onurefe/Flow/Flow2D/Analysis/PhaseRx.png

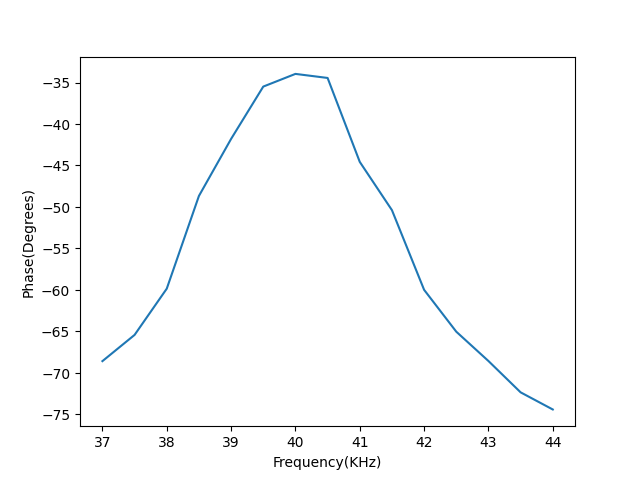
Flow2D/Analysis/PhaseRx.png
