onurefe/Flow/Flow1D/Hardware/BOM v1.0.ods

1u | https://ozdisan.com/passive-components/capacitors/smt-smd-and-mlcc-capacitors/CL10A105KO8NNNC | $0.01 | 6 | $0.05
10u | https://ozdisan.com/passive-components/capacitors/smt-smd-and-mlcc-capacitors/CL10A106MQ8NNNC | $0.02 | 1 | $0.02
100n | https://ozdisan.com/passive-components/capacitors/smt-smd-and-mlcc-capacitors/CL10B104KB8NNND | $0.00 | 6 | $0.03
1n %5 | https://ozdisan.com/passive-components/capacitors/smt-smd-and-mlcc-capacitors/CL21C102JBCNNNC | $0.01 | 1 | $0.01
1.5n %5 | https://ozdisan.com/passive-components/capacitors/smt-smd-and-mlcc-capacitors/CL21C152JBFNNNE | $0.05 | 1 | $0.05
2.2u | https://ozdisan.com/passive-components/capacitors/smt-smd-and-mlcc-capacitors/CL10A225KQ8NNNC | $0.01 | 1 | $0.01
22n | https://ozdisan.com/passive-components/capacitors/smt-smd-and-mlcc-capacitors/CC0603KRX7R9BB223 | $0.01 | 1 | $0.01
330n | https://ozdisan.com/passive-components/capacitors/smt-smd-and-mlcc-capacitors/CL10B334KO8NNNC | $0.02 | 1 | $0.02
47u 10v | https://ozdisan.com/passive-components/capacitors/tantalum-capacitors/TSK1A476TSSR | $0.16 | 1 | $0.16
2.2u 16v | https://ozdisan.com/passive-components/capacitors/smt-smd-and-mlcc-capacitors/CL10A225KO8NNNC | $0.02 | 2 | $0.04
Conn_01x04_Male | https://ozdisan.com/connectors-and-interconnects/headers/pin-headers/L-KLS1-207-1-04-S | $0.02 | 1 | $0.02
Conn_01x04_Male | https://ozdisan.com/connectors-and-interconnects/headers/pin-headers/L-KLS1-207C-2-0-1-12-S-5 | $0.10 | 1 | $0.10
Speaker_Ultrasound |  | $0.50 | 2 | $1.00
10k | https://ozdisan.com/passive-components/resistors/smt-smd-and-chip-resistors/HP03W5F1002T5E | $0.01 | 9 | $0.05
47k | https://ozdisan.com/passive-components/resistors/smt-smd-and-chip-resistors/RC0603JR-47KR | $0.00 | 1 | $0.00
1.4k %1 | https://ozdisan.com/passive-components/resistors/smt-smd-and-chip-resistors/0603SAF1401T5Ehttps://ozdisan.com/passive-components/resistors/smt-smd-and-chip-re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 | $0.00 | 1 | $0.00
2.21k %1 | https://ozdisan.com/passive-components/resistors/smt-smd-and-chip-resistors/0603SAF2211T5E | $0.00 | 1 | $0.00
470R | https://ozdisan.com/passive-components/resistors/smt-smd-and-chip-resistors/0603SAJ0471TDE | $0.00 | 1 | $0.00
22R | https://ozdisan.com/passive-components/resistors/smt-smd-and-chip-resistors/0603SAJ0220T5E | $0.00 | 2 | $0.00
4.7k | https://ozdisan.com/passive-components/resistors/smt-smd-and-chip-resistors/CQ03SAJ0472T5E | $0.00 | 1 | $0.00
NC7SB3157P6X | https://ozdisan.com/Product/Detail/487925/NC7SB3157P6X | $0.18 | 2 | $0.36
TLV9062 | https://ozdisan.com/Product/Detail/582269/TLV9062IDR | $0.64 | 1 | $0.64
STM32L031F4Px | https://ozdisan.com/Product/Detail/492349/STM32L031F4P6 | $2.85 | 1 | $2.85
LR9102G | https://ozdisan.com/Product/Detail/497420/LR9102G-33-AE5-R | $0.08 | 2 | $0.17
Cost | $5.59
