onurefe/Flow/Flow2D/v2/Hardware/JLCPCB-BOM.xlsx

Comment | Designator | Footprint | LCSC Part #
47u 10v | C2 | CP_EIA-3528-21_Kemet-B_Pad1.50x2.35mm_HandSolder | C123253
1u | C4, C5, C16, C17 | C_0603_1608Metric | C386079
100n | C1, C3, C6, C7, C10, C11, C12, C13 | C_0603_1608Metric | C187860
10u | C8, C9, C14, C15 | C_0603_1608Metric | C77040
Conn_02x05_Odd_Even | J1 |  | C124370
Speaker_Ultrasound | LS1, LS2, LS3, LS4 |  | C242175
1k | R6, R7, R13, R14, R15, R22, R23 | R_0603_1608Metric | C21190
18R | R4, R5, R12, R19, R20, R21 | R_0603_1608Metric | C403044
10k | R1, R2, R3, R8, R9, R10, R11, R16, R17, R18, R24, R25 | R_0603_1608Metric | C115324
SN74LVC2G17 | U1 | SOT-23-6 | C10429
LR9102G | U2 | SOT-23-5 | C211615
GS8724TR | U3 | SOIC-14_3.9x8.7mm_P1.27mm | C157710
STM32G030F6Px | U4 | TSSOP-20_4.4x6.5mm_P0.65mm | C529330
