onurefe/Flow/Flow2D/v1/Hardware/Flow.kicad_pcb

## KiCad design Flow2D/v1/Hardware/Flow.kicad_pcb (2022-01-21, an earlier design)

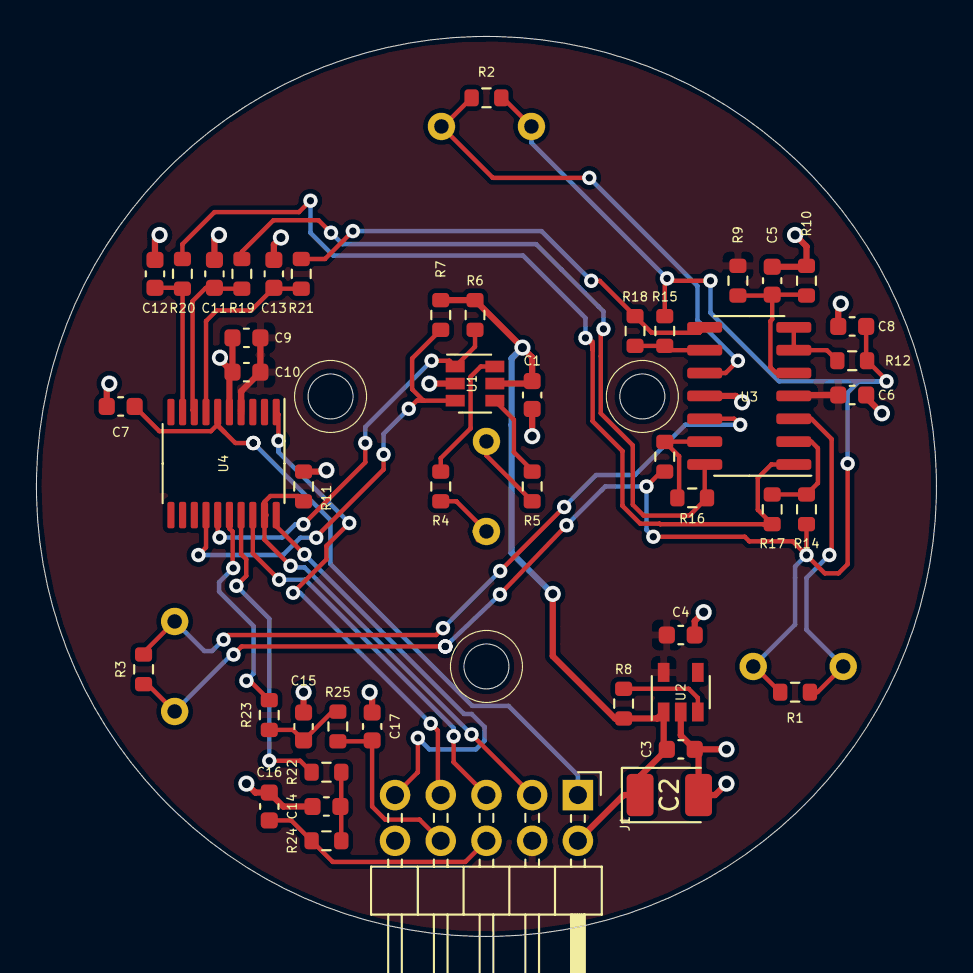
[picture p2: board Flow2D/v1/Hardware/Flow.kicad_pcb from above]

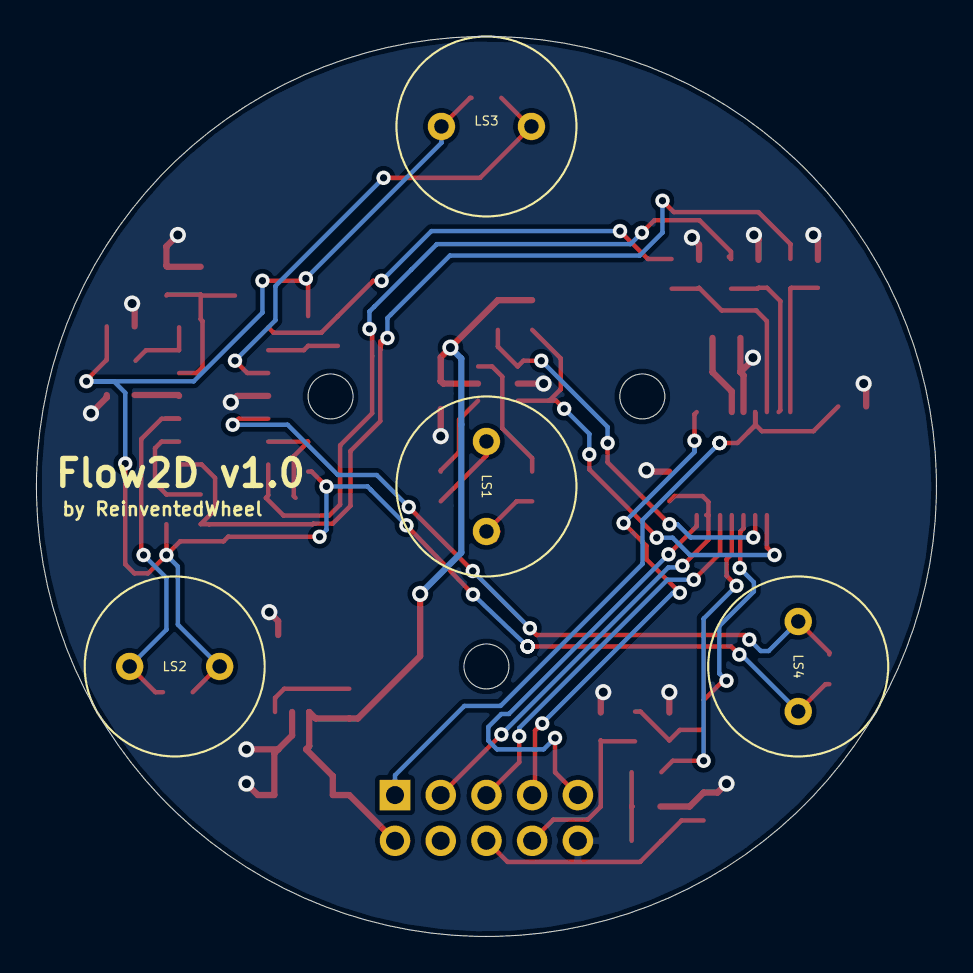
[picture p3: board Flow2D/v1/Hardware/Flow.kicad_pcb from below]

Board: 2 copper layers, 50.0 x 50.0 mm, 51 parts (4 on the bottom side), 36 nets.

Parts:
C1, C3, C6, C7, C10, C11, C12, C13: 100n; C_0603_1608Metric
C2: 47u 10v; CP_EIA-3528-21_Kemet-B_Pad1.50x2.35mm_HandSolder
C4, C5, C16, C17: 1u; C_0603_1608Metric
C8, C9, C14, C15: 10u; C_0603_1608Metric
J1: Conn_02x05_Odd_Even; PinHeader_2x05_P2.54mm_Horizontal
LS1, LS2, LS3, LS4: Speaker_Ultrasound; GU1007C-40TR
R1, R2, R3, R8, R9, R10, R11, R16, R17, R18, R24, R25: 12k; R_0603_1608Metric
R4, R5, R12, R19, R20, R21: 18R; R_0603_1608Metric
R6, R7, R13, R14, R15, R22, R23: 1k; R_0603_1608Metric
U1: SN74LVC2G17; SOT-23-6
U2: LR9102G; SOT-23-5
U3: TLV9064IDR; SOIC-14_3.9x8.7mm_P1.27mm
U4: STM32G030F6Px; TSSOP-20_4.4x6.5mm_P0.65mm

Connections:
+5V: C1.1, C2.1, C3.1, J1.2, R6.1, R7.1, R8.2, U1.5, U2.1
/CHA_A: C13.1, R21.1, U4.7
/CHA_B: C11.1, R19.1, U4.8
/CHA_C: C12.1, R20.1, U4.9
/NRST: C7.1, J1.1, U4.6
/OUT_X: C16.1, J1.6, R24.1
/OUT_Y: C17.1, J1.8, R25.1
/PULSE: R6.2, U1.1, U4.15
/PULSE_N: R7.2, U1.3, U4.14
/PWM_X: R22.2, U4.17
/PWM_Y: R23.2, U4.16
/SIGNAL_A: LS3.2, R2.1, U3.10
/SIGNAL_B: LS4.2, R3.1, U3.12
/SIGNAL_C: LS2.2, R1.1, U3.3
/SWCLK: J1.3, R11.1, U4.19
/SWDIO: J1.5, U4.18
/USART_RX: J1.7, U4.1
/USART_TX: J1.9, U4.20
/VGND: C8.1, LS2.1, LS3.1, LS4.1, R1.2, R2.2, R3.2, R12.1, R13.2, R14.2, R15.2
GND: C1.2, C2.2, C3.2, C4.1, C5.2, C6.1, C7.2, C8.2, C9.1, C10.2, C11.2, C12.2, C13.2, C14.1, C15.1, C16.2, C17.2, J1.10, R10.2, R11.2, U1.2, U2.2, U3.11, U4.5
unnamed: C5.1, R9.2, R10.1, U3.5
unnamed: C14.2, R22.1, R24.2
unnamed: C15.2, R23.1, R25.2
unnamed: LS1.1, R4.2
unnamed: LS1.2, R5.2
unnamed: R4.1, U1.6
unnamed: R5.1, U1.4
unnamed: R8.1, U2.3
unnamed: R12.2, U3.6, U3.7
unnamed: R13.1, R16.1, U3.13
unnamed: R14.1, R17.1, U3.2
unnamed: R15.1, R18.1, U3.9
unnamed: R16.2, R19.2, U3.14
unnamed: R17.2, R20.2, U3.1
unnamed: R18.2, R21.2, U3.8
VDD: C4.2, C6.2, C9.2, C10.1, J1.4, R9.1, U2.5, U3.4, U4.4
