onurefe/Flow/Flow1D/Hardware/Flow.kicad_pcb

## KiCad design Flow1D/Hardware/Flow.kicad_pcb (2021-05-09, an earlier design)

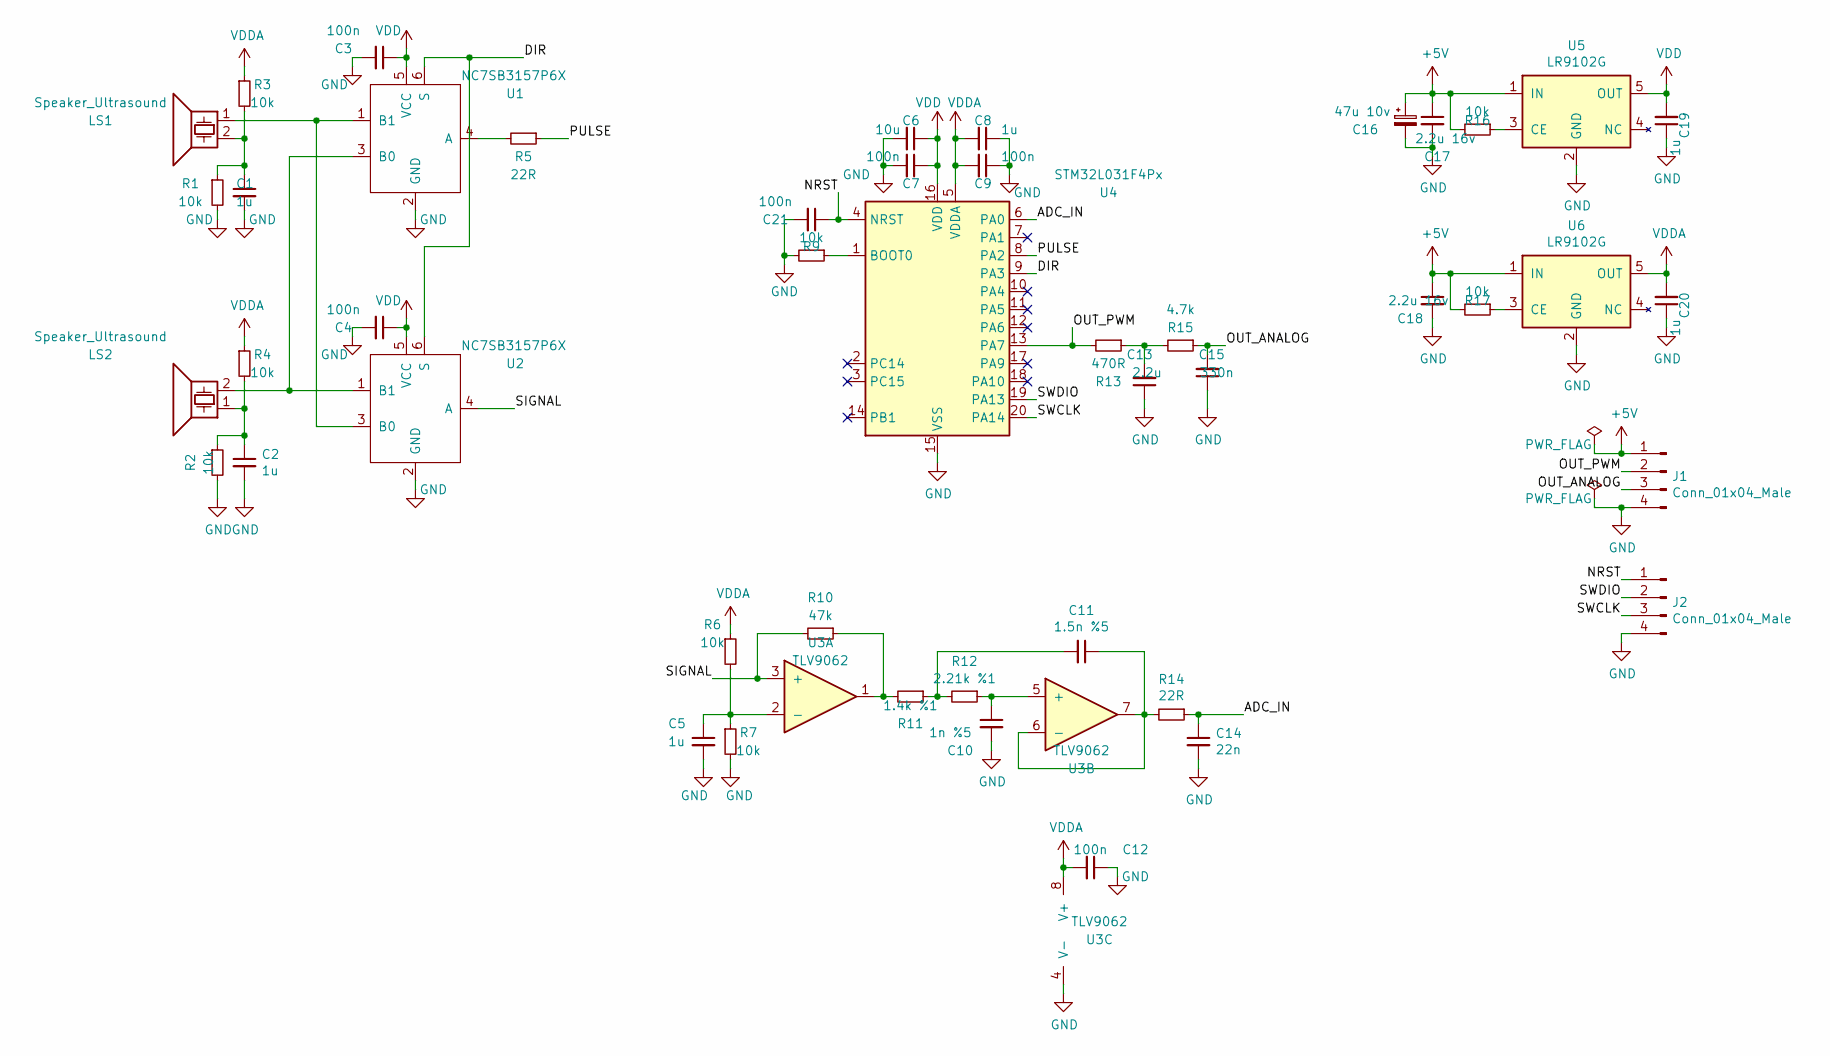
[picture p4: schematic Flow.sch]

Parts:
C1, C2, C5, C8, C19, C20: 1u; C_0603_1608Metric
C3, C4, C7, C9, C12, C21: 100n; C_0603_1608Metric
C6: 10u; C_0603_1608Metric
C10: 1n %5; C_0805_2012Metric
C11: 1.5n %5; C_0805_2012Metric
C13: 2.2u; C_0603_1608Metric
C14: 22n; C_0603_1608Metric
C15: 330n; C_0603_1608Metric
C16: 47u 10v; CP_EIA-3528-12_Kemet-T_Pad1.50x2.35mm_HandSolder
C17, C18: 2.2u 16v; C_0603_1608Metric
J1: Conn_01x04_Male; PinHeader_1x04_P2.54mm_Vertical
J2: Conn_01x04_Male; PinHeader_1x04_P1.27mm_Vertical
LS1, LS2: Speaker_Ultrasound; US_RXTX_10mm
R1, R2, R3, R4, R6, R7, R9, R16, R17: 10k; R_0603_1608Metric
R5, R14: 22R; R_0603_1608Metric
R10: 47k; R_0603_1608Metric
R11: 1.4k %1; R_0603_1608Metric
R12: 2.21k %1; R_0603_1608Metric
R13: 470R; R_0603_1608Metric
R15: 4.7k; R_0603_1608Metric
U1, U2: NC7SB3157P6X; SOT-363_SC-70-6_Handsoldering
U3: TLV9062; SOIC-8_3.9x4.9mm_P1.27mm
U4: STM32L031F4Px; TSSOP-20_4.4x6.5mm_P0.65mm
U5, U6: LR9102G; SOT-23-5_HandSoldering

Connections:
+5V: C16.1, C17.1, C18.1, J1.1, R16.2, R17.2, U5.1 (IN), U6.1 (IN)
/ADC_IN: C14.1, R14.1, U4.6 (PA0)
/DIR: U1.6 (S), U2.6 (S), U4.9 (PA3)
/NRST: C21.1, J2.1, U4.4 (NRST)
/OUT_ANALOG: C15.2, J1.3, R15.1
/OUT_PWM: J1.2, R13.2, U4.13 (PA7)
/PULSE: R5.1, U4.8 (PA2)
/SIGNAL: R10.2, U2.4 (A), U3.3 (+)
/SWCLK: J2.3, U4.20 (PA14)
/SWDIO: J2.2, U4.19 (PA13)
GND: C1.2, C2.2, C3.2, C4.2, C5.2, C6.2, C7.2, C8.1, C9.1, C10.2, C12.1, C13.1, C14.2, C15.1, C16.2, C17.2, C18.2, C19.1, C20.1, C21.2, J1.4, J2.4, R1.2, R2.2, R7.2, R9.2, U1.2 (GND), U2.2 (GND), U3.4 (V-), U4.15 (VSS), U5.2 (GND), U6.2 (GND)
unnamed: C1.1, LS1.2, R1.1, R3.2
unnamed: C2.1, LS2.1, R2.1, R4.2
unnamed: C5.1, R6.2, R7.1, U3.2 (-)
unnamed: C10.1, R12.1, U3.5 (+)
unnamed: C11.1, R14.2, U3.6 (-), U3.7
unnamed: C11.2, R11.1, R12.2
unnamed: C13.2, R13.1, R15.2
unnamed: LS1.1, U1.1 (B1), U2.3 (B0)
unnamed: LS2.2, U1.3 (B0), U2.1 (B1)
unnamed: R5.2, U1.4 (A)
unnamed: R9.1, U4.1 (BOOT0)
unnamed: R10.1, R11.2, U3.1
unnamed: R16.1, U5.3 (CE)
unnamed: R17.1, U6.3 (CE)
VDD: C3.1, C4.1, C6.1, C7.1, C19.2, U1.5 (VCC), U2.5 (VCC), U4.16 (VDD), U5.5 (OUT)
VDDA: C8.2, C9.2, C12.2, C20.2, R3.1, R4.1, R6.1, U3.8 (V+), U4.5 (VDDA), U6.5 (OUT)

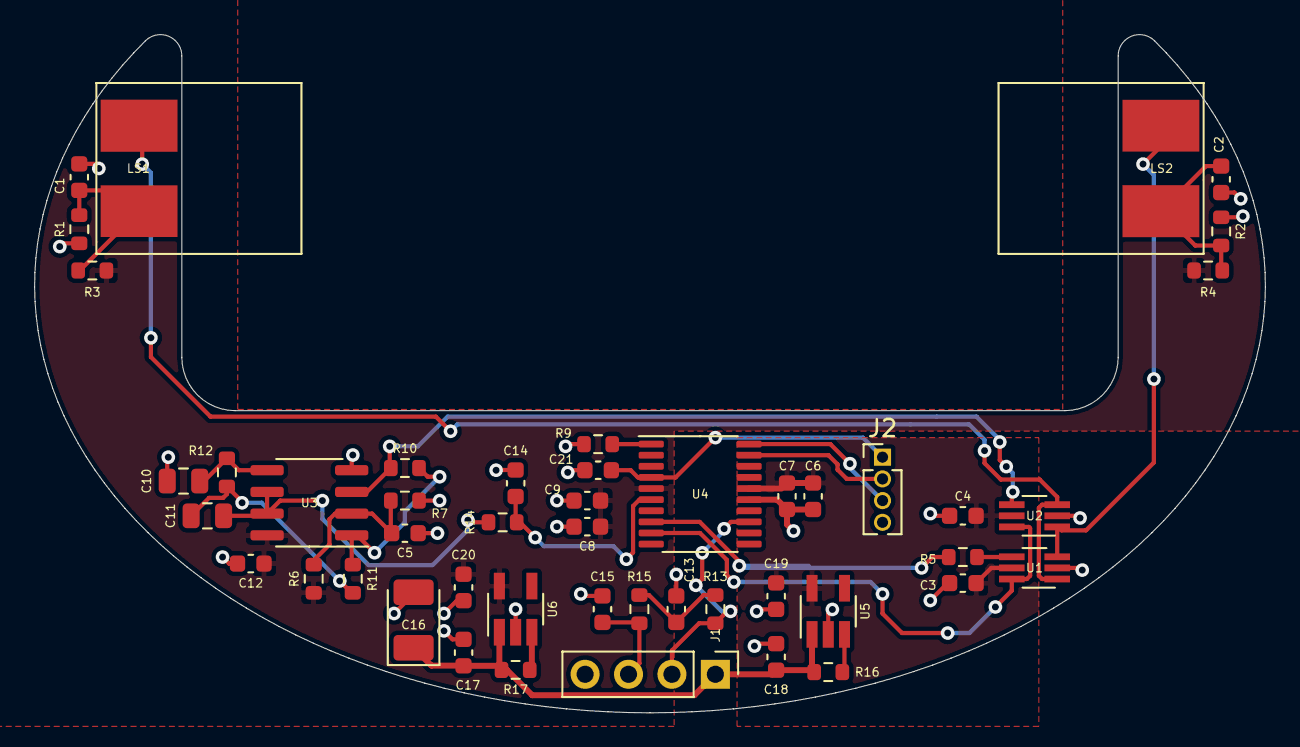
[picture p5: board Flow1D/Hardware/Flow.kicad_pcb from above]

Board: 2 copper layers, 72.0 x 39.7 mm, 47 parts (0 on the bottom side), 27 nets.
