onurefe/Flow/Flow2D/v2/Firmware/Core/Src/main.c

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
/* Includes ------------------------------------------------------------------*/
#include "main.h"

/* USER CODE BEGIN Includes */
#include "qfplib.h"
#include "complex.h"
#include "flow.h"
#include "config.h"
#include "flash.h"
#include "temperature.h"
/* USER CODE END Includes */

ADC_HandleTypeDef hadc1;
DMA_HandleTypeDef hdma_adc1;

TIM_HandleTypeDef htim1;
TIM_HandleTypeDef htim3;
DMA_HandleTypeDef hdma_tim1_ch1;

/* USER CODE BEGIN PV */
static Flow_Calibration_t Calibration;
static Bool_t CalibrationCompleted = FALSE;
static Bool_t SearchCompleted = FALSE;
static float Search2CalibrationOffset;
static float Temperature;
/* USER CODE END PV */

void SystemClock_Config(void);
static void MX_GPIO_Init(void);
static void MX_DMA_Init(void);
static void MX_ADC1_Init(void);
static void MX_TIM1_Init(void);
static void MX_TIM3_Init(void);
/* USER CODE BEGIN PFP */
static void measurementCompletedCb(float vx, float vy, float temperature);
static void calibrationCompletedCb(Flow_Calibration_t *calibration);
static void searchCompletedCb(float search2CalibrationOffset, float correlation, float temperature);
/* USER CODE END PFP */

/**
  * @brief  The application entry point.
  * @retval int
  */
int main(void)
{
  /* MCU Configuration--------------------------------------------------------*/

  /* Reset of all peripherals, Initializes the Flash interface and the Systick. */
  HAL_Init();

  /* Configure the system clock */
  SystemClock_Config();

  /* Initialize all configured peripherals */
  MX_GPIO_Init();
  MX_DMA_Init();
  MX_ADC1_Init();
  MX_TIM1_Init();
  MX_TIM3_Init();
  /* USER CODE BEGIN 2 */
  // Start pwm output channel(for X axis).
  if (HAL_TIM_PWM_Start(&htim1, TIM_CHANNEL_2) != HAL_OK)
  {
    while (1)
      ;
  }

  // Start pwm output channel(for Y axis).
  if (HAL_TIM_PWM_Start(&htim1, TIM_CHANNEL_3) != HAL_OK)
  {
    while (1)
      ;
  }

  // Restore calibration data. If it doesn't exist, run calibrate function.
  //Flash_Restore((uint64_t *)&Calibration, sizeof(Calibration));
  //if (Calibration.flashCode != FLASH_CODE)
  //{
  Flow_Calibrate(&Calibration, Temperature_GetSpeedOfSound(FLOW_ROOM_TEMPERATURE),
                 calibrationCompletedCb);
  //}
  //else
  //{
  // Flow_RunParams_t params;
  //params.downsamplingNumber = 10;
  // params.temperatureFilterTc = 1.0f;
  // params.velocityFilterTc = 0.1f;

  //Flow_Run(&Calibration, &params, measurementCompletedCb);
  //}
  /* USER CODE END 2 */

  /* Infinite loop */
  /* USER CODE BEGIN WHILE */
  while (1)
  {
    Flow_Execute();

    if (CalibrationCompleted)
    {
      // Store calibration data to flash memory.
      //Calibration.flashCode = FLASH_CODE;
      //if (Flash_Store((uint64_t *)&Calibration, (sizeof(Flow_Calibration_t) / sizeof(uint64_t))) != HAL_OK)
      //{
      //Error_Handler();
      //}
      Flow_SearchSpeedOfSound(&Calibration, searchCompletedCb);
      //Flow_RunParams_t params;
      //params.downsamplingNumber = 250;
      //params.temperatureFilterTc = 1.0f;
      //params.velocityFilterTc = 0.1f;

      //Flow_Run(&Calibration, &params, measurementCompletedCb);

      CalibrationCompleted = FALSE;
    }
    
    if (SearchCompleted)
    {
      Flow_SearchSpeedOfSound(&Calibration, searchCompletedCb);
      SearchCompleted = FALSE;
    }
    
    /*
    if (SearchCompleted)
    {
      Flow_RunParams_t params;
      params.downsamplingNumber = 5;
      params.temperatureFilterTc = 0.1f;
      params.velocityFilterTc = 0.05f;

      Flow_Run(&Calibration, Search2CalibrationOffset, &params, measurementCompletedCb);

      SearchCompleted = FALSE;
    }
    */
    /* USER CODE END WHILE */

    /* USER CODE BEGIN 3 */
  }
  /* USER CODE END 3 */
}

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
/* USER CODE BEGIN 4 */
static void measurementCompletedCb(float vx, float vy, float temperature)
{
  // Update analog outputs.
  uint16_t comp_x, comp_y;
  comp_x = (uint16_t)qfp_fmul(qfp_fadd(0.5f, qfp_fmul(vx, (1.0f / DEFAULT_PWM_RANGE))), qfp_int2float(TIM1_RUN_RELOAD));
  comp_y = (uint16_t)qfp_fmul(qfp_fadd(0.5f, qfp_fmul(vy, (1.0f / DEFAULT_PWM_RANGE))), qfp_int2float(TIM1_RUN_RELOAD));

  __HAL_TIM_SET_COMPARE(&htim1, TIM_CHANNEL_2, comp_x);
  __HAL_TIM_SET_COMPARE(&htim1, TIM_CHANNEL_3, comp_y);
}

static void calibrationCompletedCb(Flow_Calibration_t *calibration)
{
  CalibrationCompleted = TRUE;
}

static void searchCompletedCb(float search2CalibrationOffset, float correlation, float temperature)
{
  Search2CalibrationOffset = search2CalibrationOffset;
  Temperature = temperature;
  SearchCompleted = TRUE;
}
/* USER CODE END 4 */
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
