onurefe/Flow/Flow2D/v1/Firmware/Flow2D.ioc

Mcu.UserName=STM32G030F6Px
PA0.GPIO_Label=CHA_A
PA0.Signal=ADC1_IN0
PA1.GPIO_Label=CHA_B
PA1.Signal=ADC1_IN1
PA13.Signal=SYS_SWDIO
PA14-BOOT0.Signal=SYS_SWCLK
PA2.GPIO_Label=CHA_C
PA2.Signal=ADC1_IN2
PA7.GPIO_Label=PULSE_N
PA7.Signal=TIM1_CH1N
PA8.GPIO_Label=PULSE
PA8.Signal=S_TIM1_CH1
