onurefe/Flow/Flow1D/Firmware/Core/Inc/main.h

#define SYS_FREQ 32000000
#define US_FREQ 40000
#define SAMPLES_PER_CYCLE 4
#define TIM2_RELOAD ((((SYS_FREQ/US_FREQ)/SAMPLES_PER_CYCLE)*SAMPLES_PER_CYCLE)-1)
#define TIM21_RELOAD (SYS_FREQ/(SAMPLES_PER_CYCLE*US_FREQ)-1)
#define TIM2_CH3_PULSE (TIM2_RELOAD/2)
#define TIM21_CH2_PULSE (TIM21_RELOAD/2)
#define ANOUT_RESOLUTION 1024
#define TIM22_RELOAD (ANOUT_RESOLUTION-1)
#define DEAD_SAMPLES 80 
#define SAMPLES_PER_PHASE_MEASUREMENT 400
#define ADC_IN_Pin GPIO_PIN_0
#define ADC_IN_GPIO_Port GPIOA
#define PULSE_Pin GPIO_PIN_2
#define PULSE_GPIO_Port GPIOA
#define DIR_Pin GPIO_PIN_3
#define DIR_GPIO_Port GPIOA
#define ANOUT_PWM_Pin GPIO_PIN_7
#define ANOUT_PWM_GPIO_Port GPIOA
