onurefe/Flow/Flow1D/Firmware/Core/Src/fast_math.c

#include "fast_math.h"
#include "math.h"

// Polynomial approximating arctangenet on the range -1,1.
// Max error < 0.005 (or 0.29 degrees)
float FastMath_Atan(float z)
{
    const float n1 = 0.97239411f;
    const float n2 = -0.19194795f;
    return (n1 + n2 * z * z) * z;
}

float FastMath_Atan2(float x, float y)
{
    if (x != 0.0f)
    {
        if (fabsf(x) > fabsf(y))
        {
            const float z = y / x;
            if (x > 0.0)
            {
                // atan2(y,x) = atan(y/x) if x > 0
                return FastMath_Atan(z);
            }
            else if (y >= 0.0)
            {
                // atan2(y,x) = atan(y/x) + PI if x < 0, y >= 0
                return FastMath_Atan(z) + M_PI;
            }
            else
            {
                // atan2(y,x) = atan(y/x) - PI if x < 0, y < 0
                return FastMath_Atan(z) - M_PI;
            }
        }
        else // Use property atan(y/x) = PI/2 - atan(x/y) if |y/x| > 1.
        {
            const float z = x / y;
            if (y > 0.0)
            {
                // atan2(y,x) = PI/2 - atan(x/y) if |y/x| > 1, y > 0
                return -FastMath_Atan(z) + M_PI_2;
            }
            else
            {
                // atan2(y,x) = -PI/2 - atan(x/y) if |y/x| > 1, y < 0
                return -FastMath_Atan(z) - M_PI_2;
            }
        }
    }
    else
    {
        if (y > 0.0f) // x = 0, y > 0
        {
            return M_PI_2;
        }
        else if (y < 0.0f) // x = 0, y < 0
        {
            return -M_PI_2;
        }
    }
    return 0.0f; // x,y = 0. Could return NaN instead.
}
