onurefe/Flow/(commit log)

2021-05-09 Flow1D v1.0 hardware completed. Firmware work needed.
    TO DO: Port old firmware to the new platform and library(LL->HAL and STM32F031->STM32L031).
    TO DO: Improve measurement algorithm.
    [BOM v1.0.ods, Flow.kicad_pcb, Flow.sch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]
2021-05-31 Backbone of the firmware created.
    +Flow source code needs testing.
    +Theoretical background needs additional verification.
2021-06-06 Test case for the whole speed extraction algorithm.
    +Project works in test case environment. Now it's needed to base it on hardware.
    +Simplification of demodulation algorithm.
2021-07-13 Working firmware. Prototype v1.0
    +Hardware modifications. Addition of parallel resistors to the transceiver pair.
    +Compensation phasor added.
    +Peripheral configuration problems resolved.
    +Cutoff frequency of the output filter decreased to like 15Hz.
    TODO: Calibration can be added. This way; we needed to add compensation manually. What leads to the mismatch?
    [Flow.ioc, complex.c, complex.h, fast_math.h, flow.c, flow.h, generic.h, main.c]
2021-09-18 Flow2D fabrication files added.
    Unfortunately schematic file is lost.
    [BOM.xlsx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]
2021-09-24 Hardware files of Flow2D found.
    [BOM.xlsx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]
2021-09-26 Multiple frequency code base is written.
    TODO:
    +Test on hardware.
    +Implement a measurement algorithm.
    +Output using PWM's.
2021-10-07 Problems related to firmware are solved.
    +Signal level is too low; like 200mV. Need to be increased.
    +Need to be tested with a plastic ring.
    +Piezodriver units response is unknown, need to be determined.
    +A bit more calculation about vectors required.
    +No need for making DMA of the TIM1 active, could be deactivated.
    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
    [Flow.kicad_pcb, Flow.sch]
2022-01-21 Works well seemingly!
    TODO: Zero point drift need to be solved.
    TODO: UART communication firmware needed to be added.
    [Flow.kicad_pcb]
2022-07-05 Added v2 schematic. Main idea is to correct for transducer shifts.
    [Flow.kicad_pcb, Flow.kicad_sch, Flow.sch, JLCPCB-BOM.xlsx, afe.kicad_sch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]
